BMathi9s/Robowars2026-GreenShift/README.md

# Robowars2026-GreenShift
GreenShift repo for the Concordia Robowars

Rtos 

platform io

Greenshift main project
