BMathi9s/Robowars2026-GreenShift/Screenshot 2026-05-17 105902.png

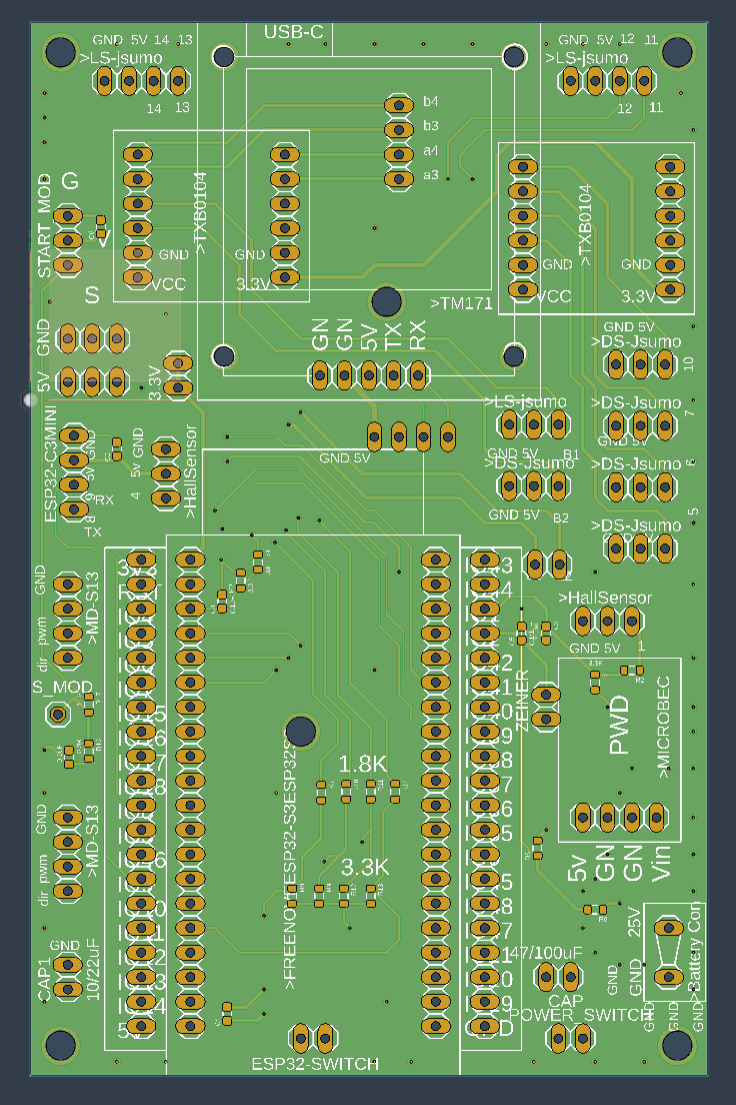
Screenshot 2026-05-17 105902.png
