BMathi9s/Robowars2026-GreenShift/Black_2026 v8.step

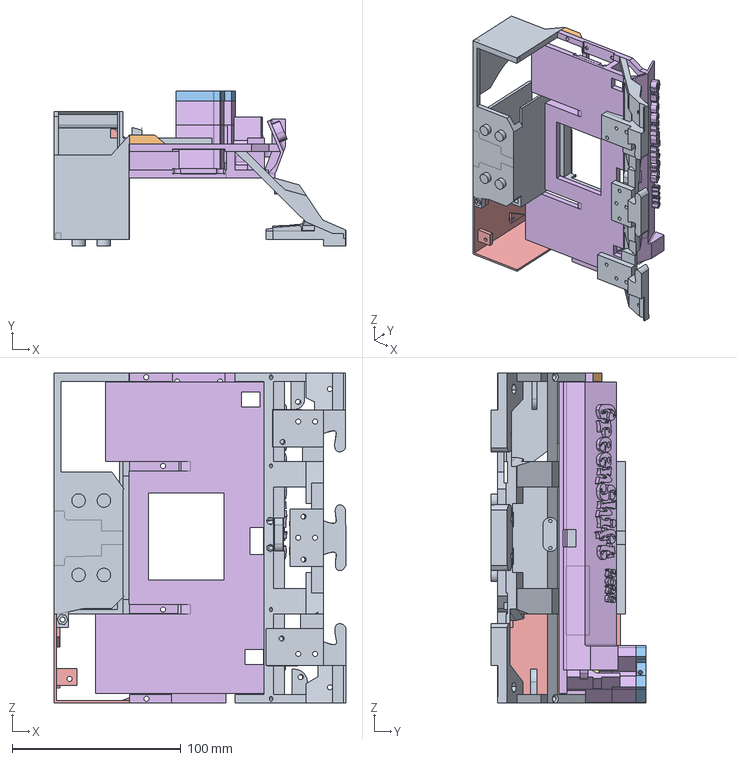
[picture p6: CAD file, 2026-05-17]
Black_2026 v8.step
172.7 x 92.0 x 195.3 mm
