BMathi9s/Robowars2026-GreenShift/blade v4 v2.step

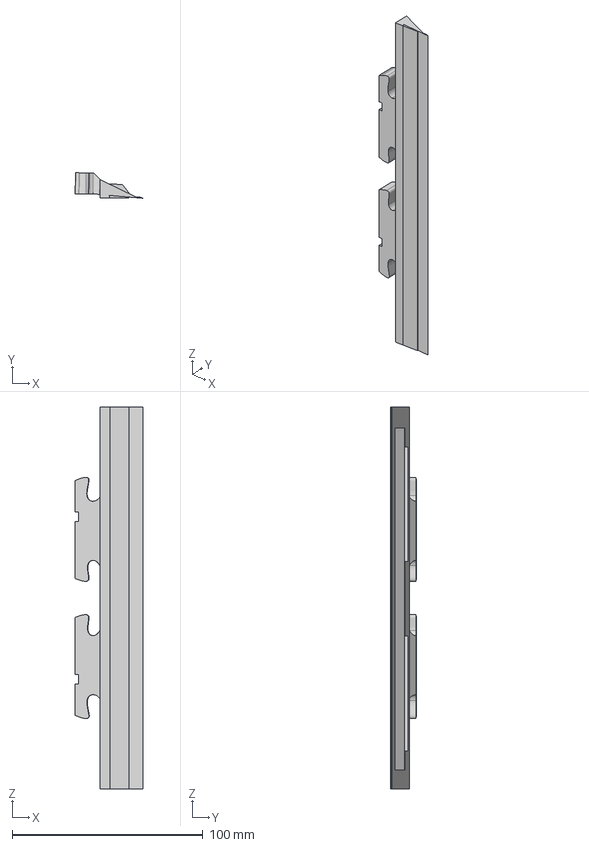
[picture p7: CAD file, 2026-05-17]
blade v4 v2.step
35.5 x 13.4 x 200.0 mm
